stefanpatriche/Patriche-Stefan_perpetuum2021/Photos/DVD_Writere_desfacute.jpeg

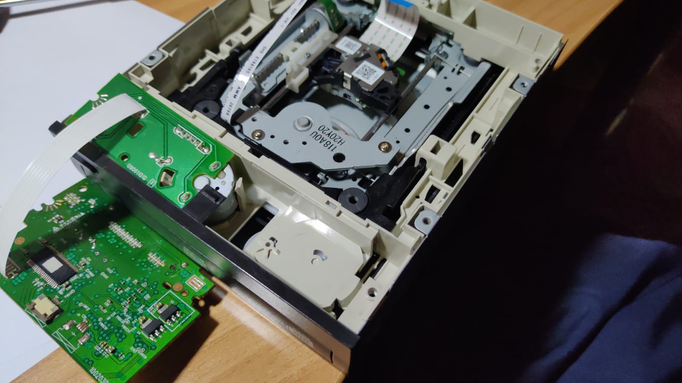
Photos/DVD_Writere_desfacute.jpeg
