stefanpatriche/Patriche-Stefan_perpetuum2021/(commit log)

2021-05-10 add gantt diagram
    [Gantt_diagram.xlsx]
2021-05-23 testing stepper
